Yasmine290/PROJET_ELECTRONIQUE/README.md

# Projet de conception en Électronique  

Ce projet fait partie d'un travail en électronique visant à concevoir un amplificateur audio Bluetooth.  

## 📄 Rapport du projet  
Le rapport détaillé du projet est disponible dans les fichiers du dépôt, sur la branche `main`.
