Yasmine290/PROJET_ELECTRONIQUE/(list of files, drawings)

Other design files:
LIBRAIRIE PCB.PcbLib
LIBRAIRIE PROJET.SchLib
PCB3.PcbDoc
PROJET ELECTRO.PrjPcb
Sheet2.SchDoc
